0xJeremy/Icarus/README.md

# Icarus Power Distribution Board

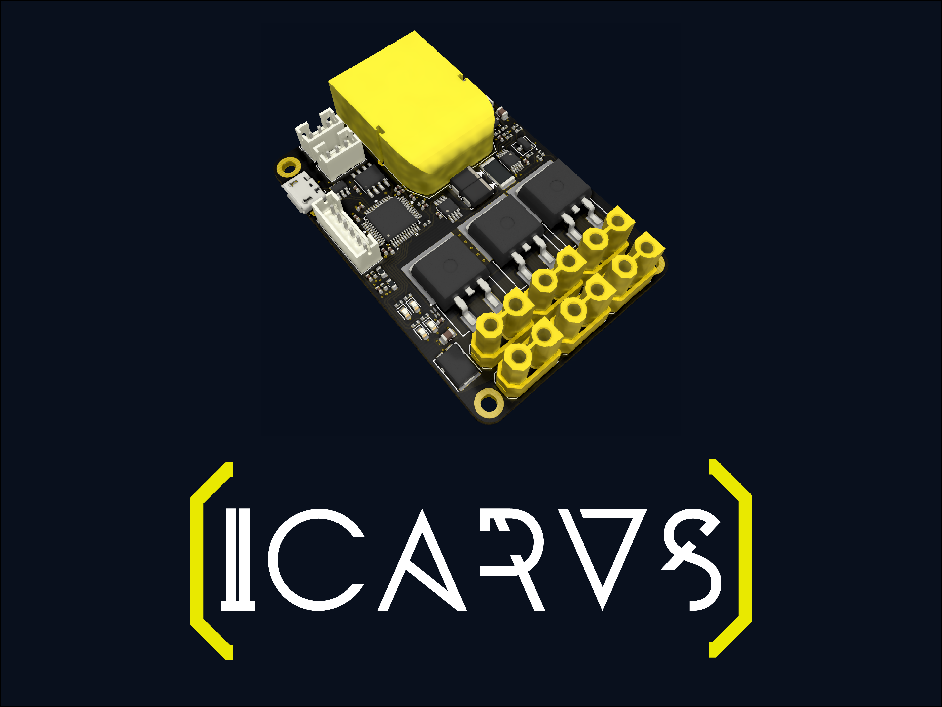
[picture p1: docs/logo/Icarus_Board.png]


### Board Layout
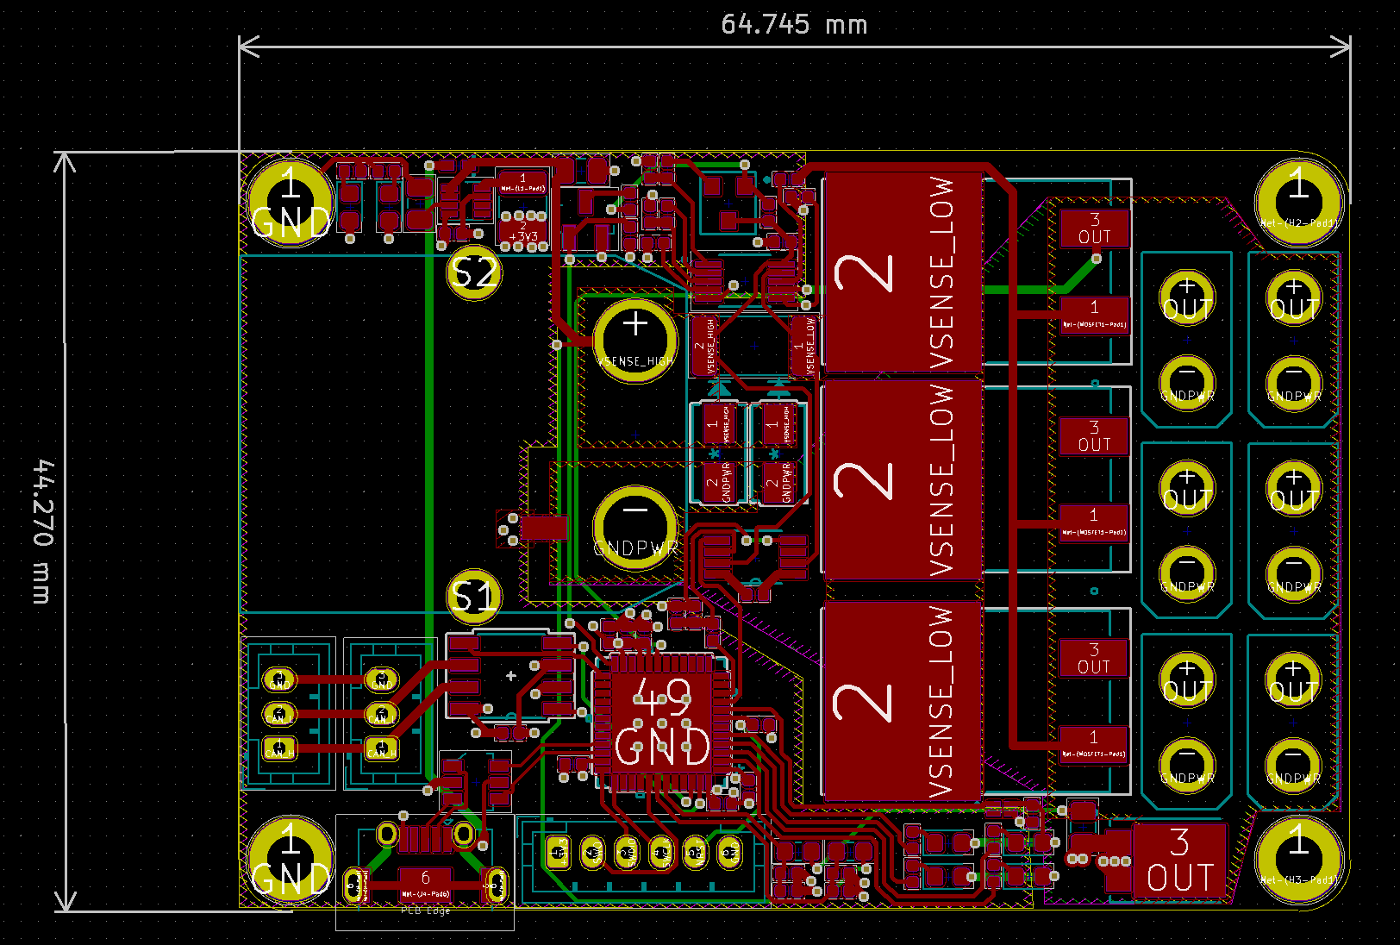
[picture p2: docs/Board_Layout.png]
Board Layout
