0xJeremy/Icarus/docs/Back.jpg

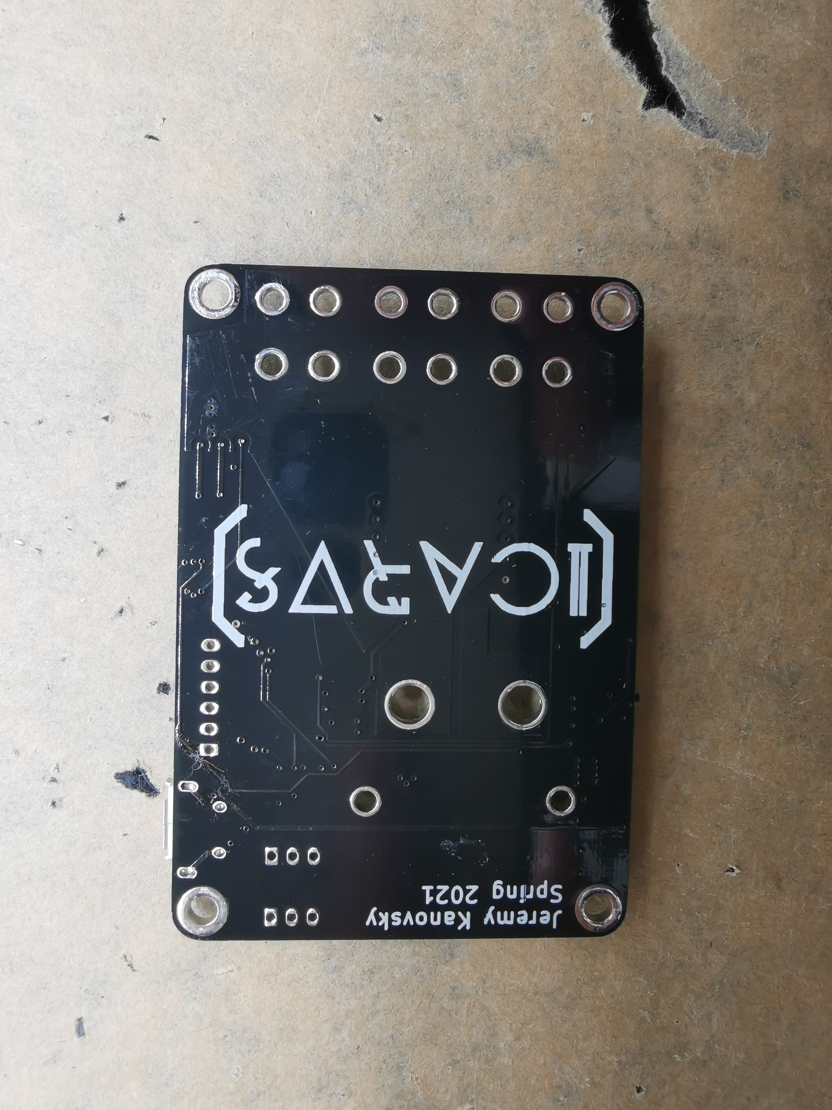
docs/Back.jpg
