0xJeremy/Icarus/docs/renders/Isometric.png

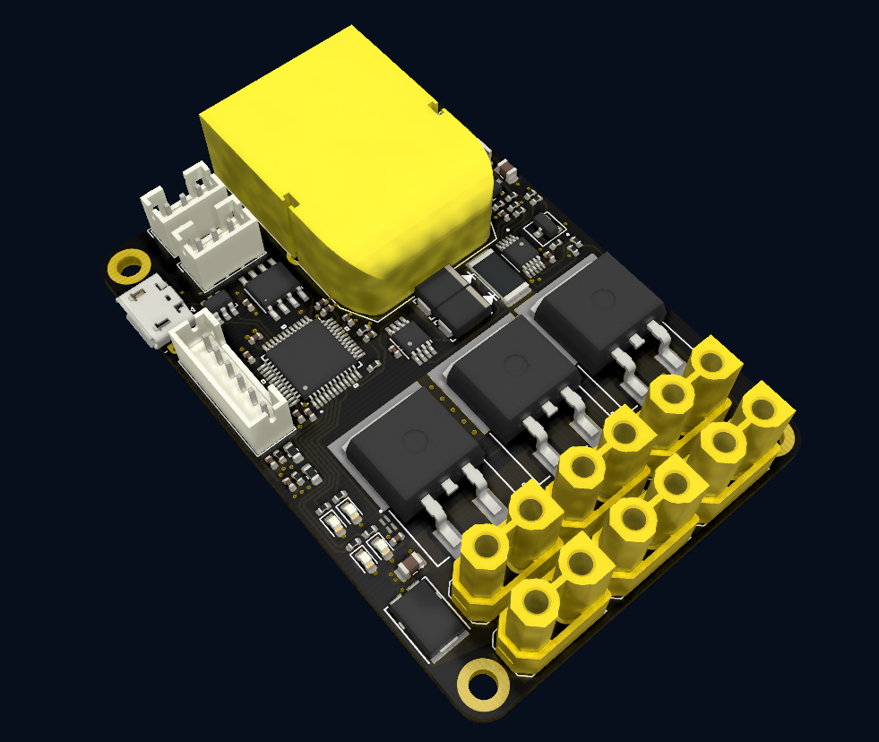
docs/renders/Isometric.png
