0xJeremy/Icarus/docs/renders/Side.png

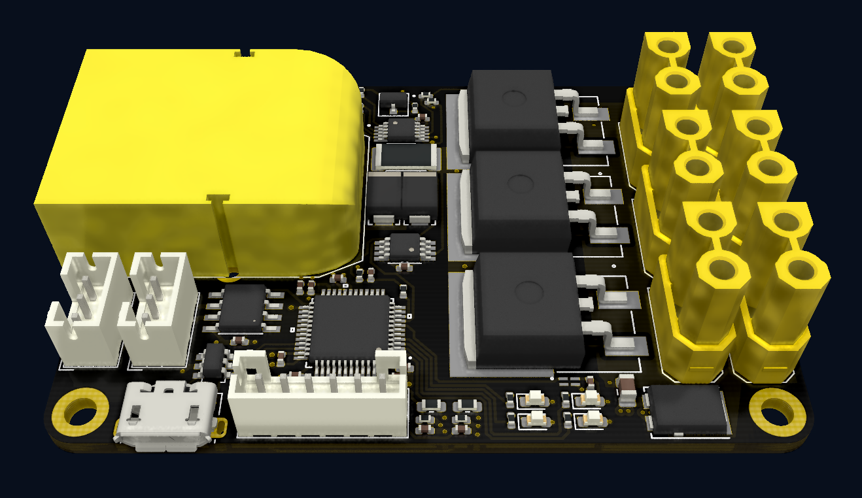
docs/renders/Side.png
