0xJeremy/Icarus/docs/renders/Top (Render).png

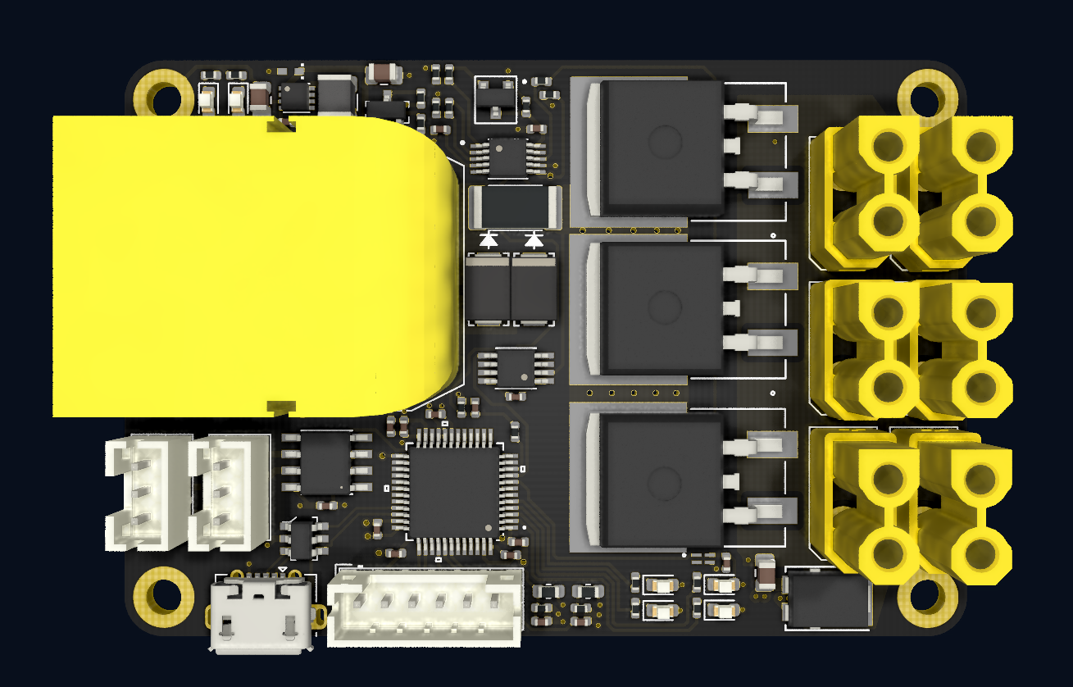
docs/renders/Top (Render).png
