0xJeremy/Icarus/docs/renders/Top.png

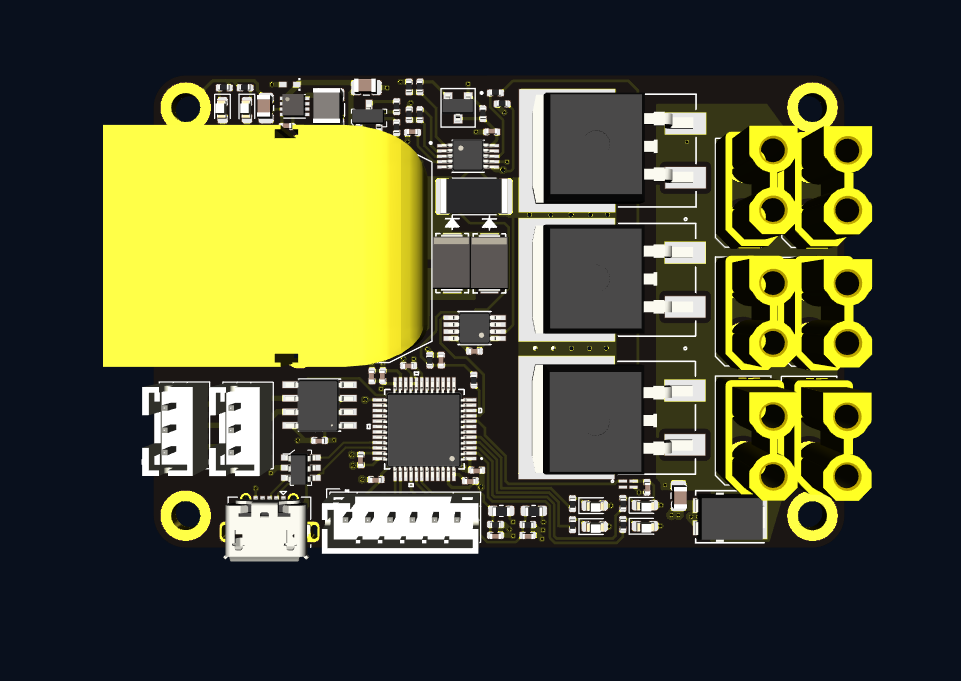
docs/renders/Top.png
