0xJeremy/Icarus/icarus_bom.xlsx

Item # | Designator | Qty | Manufacturer | Mfg Part # | Description/Value | Package/Footprint | Type | Your Instructions/Notes | Digi-Key/Mouser Link
1 | C14 | 1 | KEMET | C0402C103K5RECAUTO | CAP CER 10NF 50V 0402 | 0402 | SMD | NOTE: For all items I have included a link to Digi-Key or Mouser. It does not matter if the items are purchased from these sites or not, I included them as reference in case any of the manufacturer, manufacturer part numbers, or footprints are unclear. | https://www.digikey.com/en/products/detail/kemet/C0402C103K5RECAUTO/8646477
2 | C19 C18 | 2 | CAL-CHIP ELECTRONICS, INC. | GMC04X7R103K6R3NT | CAP CER 0.01UF 6.3V 0402 | 0402 | SMD |  | https://www.digikey.com/en/products/detail/cal-chip-electronics-inc/GMC04X7R103K6R3NT/13908424
3 | C3 C13 | 2 | Murata Electronics | GRJ155R60J106ME11D | CAP CER 10UF 6.3V 0402 | 0402 | SMD |  | https://www.digikey.com/en/products/detail/murata-electronics/GRJ155R60J106ME11D/5877374
4 | C4 C2 C7 | 3 | TDK Corporation | C2012X7S2A105K125AB | CAP CER 1UF 100V 0805 | 0805 | SMD |  | https://www.digikey.com/en/products/detail/tdk-corporation/C2012X7S2A105K125AB/2116321
5 | C6 | 1 | Murata Electronics | GRM155R62A104KE14D | CAP CER 0.1UF 100V 0402 | 0402 | SMD |  | https://www.digikey.com/en/products/detail/murata-electronics/GRM155R62A104KE14D/5027543
6 | C8 | 1 | Yageo | CC0402KRX5R5BB105 | CAP CER 1UF 6.3V 0402 | 0402 | SMD |  | https://www.digikey.com/en/products/detail/yageo/CC0402KRX5R5BB105/2833603
7 | C9 C10 C11 C1 C5 C15 C16 C17 C12 | 9 | CAL-CHIP ELECTRONICS, INC. | GMC04X5R104K10NT | CAP CER 0.1UF 10V 0402 | 0402 | SMD |  | https://www.digikey.com/en/products/detail/cal-chip-electronics-inc/GMC04X5R104K10NT/13908671
8 | CR1 CR2 | 2 | Vishay General Semiconductor - Diodes Division | SMBJ51CA-E3/52 | DIODE 82.4V 600W DO-214AA | DO-214AA | SMD |  | https://www.digikey.com/en/products/detail/vishay-semiconductor-diodes-division/smbj51ca-e3-52/1119303
9 | D1 | 1 | ON Semiconductor | ON Semiconductor | DIODE 30V 200MA SOD-523F | SOD-523F | SMD |  | https://www.digikey.com/en/products/detail/on-semiconductor/rb520s30/1955134
10 | D3 D2 | 2 | Kingbright | APT1608CGCK | LED 0603 GREEN | 0603 | SMD |  | https://www.digikey.com/en/products/detail/kingbright/APT1608CGCK/1747514
11 | D4 D5 D6 D7 | 4 | Rohm Semiconductor | SMLE13BC8TT86 | LED 0603 BLUE | 0603 | SMD |  | https://www.digikey.com/en/products/detail/rohm-semiconductor/SMLE13BC8TT86/5053771
12 | J4 | 1 | Molex | 475890001 | CONN MICRO USB B |  | SMD/Thru-hole |  | https://www.digikey.com/en/products/detail/molex/0475890001/1832253
13 | L1 | 1 | Taiyo Yuden | CBC3225T330KR | INDUCTOR 33UH 533MOHM 1210 | 1210 | SMD |  | https://www.digikey.com/en/products/detail/taiyo-yuden/CBC3225T330KR/2763320
14 | MOSFET1 MOSFET3 MOSFET5 | 3 | Nexperia USA Inc. | PSMN4R8-100BSEJ | N-CHANNEL MOSFET 100V 120A D2PAK | D2PAK | SMD |  | https://www.digikey.com/en/products/detail/nexperia-usa-inc/PSMN4R8-100BSEJ/4020506
15 | MOSFET2 | 1 | Diodes Incorporated | ZXMP10A13FTA | P-CHANNEL MOSFET 100V 600MA SOT-23-3 | SOT-23-3 | SMD |  | https://www.digikey.com/en/products/detail/diodes-incorporated/zxmp10a13fta/560644
16 | MOSFET4 | 1 | ON Semiconductor | BSS123 | N-CHANNEL MOSFET 100V 170MA SOT-23-3 | SOT-23-3 | SMD |  | https://www.digikey.com/en/products/detail/on-semiconductor/BSS123/244348
17 | R1 | 1 | Stackpole Electronics Inc | CSNL2512FTL500 | RESISTOR 500UOHM 1% 2W 2512 | 2512 | SMD |  | https://www.digikey.com/en/products/detail/stackpole-electronics-inc/CSNL2512FTL500/1788105
18 | R14 R2 | 2 | Yageo | RC0402FR-0747KL | RESITOR 47K OHM 1% 0402 | 0402 | SMD |  | https://www.digikey.com/en/products/detail/yageo/RC0402FR-0747KL/726616
19 | R15 | 1 | Panasonic Electronic Components | ERJ-2GEJ474X | RESISTOR 470K OHM 0402 | 0402 | SMD |  | https://www.digikey.com/en/products/detail/panasonic-electronic-components/ERJ-2GEJ474X/147018
20 | R16 R17 R18 | 3 | Venkel | CR0402-16W-6801FT | RESISTOR 6.8 KOHM 1% 0402 | 0402 | SMD |  | https://www.digikey.com/en/products/detail/venkel/CR0402-16W-6801FT/12329730
21 | R20 R19 | 2 | Yageo | RC0603FR-073ML | RESISTOR 3M OHM 0603 | 0603 | SMD |  | https://www.digikey.com/en/products/detail/yageo/RC0603FR-073ML/5918344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
22 | R22 R21 | 2 | Yageo | RC0402FR-07200KL | RESISTOR 200K OHM 1% 0402 | 0402 | SMD |  | https://www.digikey.com/en/products/detail/yageo/RC0402FR-07200KL/726558
23 | R3 R8 | 2 | Yageo | RC0402FR-07100KL | RESISTOR 100K OHM 0402 | 0402 | SMD |  | https://www.digikey.com/en/products/detail/yageo/RC0402FR-07100KL/726526
24 | R5 R10 R4 R11 R12 R13 | 6 | Venkel | CR0402-16W-221JT | RESISTOR 220 OHM 0402 | 0402 | SMD |  | https://www.digikey.com/en/products/detail/venkel/CR0402-16W-221JT/12329552
25 | R6 | 1 | Yageo | RC0402JR-0710RL | RESISTOR 10 OHM 0402 | 0402 | SMD |  | https://www.digikey.com/en/products/detail/yageo/RC0402JR-0710RL/726417
26 | R7 | 1 | KOA Speer Electronics, Inc. | RK73H1ETTP4993F | RESISTOR 499K OHM 1% 0402 | 0402 | SMD |  | https://www.digikey.com/en/products/detail/koa-speer-electronics-inc/RK73H1ETTP4993F/9844110
27 | R9 | 1 | Yageo | RC0402FR-07140KL | RESISTOR 140K OHM 1% 0402 | 0402 | SMD |  | https://www.digikey.com/en/products/detail/yageo/RC0402FR-07140KL/5280838
28 | U1 | 1 | Maxim Integrated | MAX15062AATA+T | IC VOLTAGE REGULATOR 3.3V 300MA 8-WFDFN | 8-WFDFN | SMD |  | https://www.digikey.com/en/products/detail/maxim-integrated/MAX15062AATA-T/2591307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
29 | U13 | 1 | Analog Devices Inc. | LT1787HVIMS8#PBF | IC CURRENSE SENSE AMPLIFIER 8-MSOP | 8-MSOP | SMD |  | https://www.mouser.com/ProductDetail/Analog-Devices/LT1787HVIMS8PBF
30 | U14 | 1 | STMicroelectronics | USBLC6-2SC6 | DIODE 17V 5A SOT-23-6 | SOT-23-6 | SMD |  | https://www.digikey.com/en/products/detail/stmicroelectronics/USBLC6-2SC6/1040559
31 | U15 | 1 | STMicroelectronics | STLM20DD9F | IC TEMPERATURE SENSOR 4-UDFN | 4-UDFN | SMD |  | https://www.digikey.com/en/products/detail/stmicroelectronics/STLM20DD9F/1506426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
32 | U2 | 1 | STMicroelectronics | STM32G474CET6 | IC STM32G474CET6 48-UFQFPN | 48-UFQFPN | SMD |  | https://www.digikey.com/en/products/detail/stmicroelectronics/STM32G474CET6/10326773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
33 | U3 | 1 | Texas Instruments | TCAN334GDR | IC CAN BUS DRIVER 8-SOIC | 8-SOIC | SMD |  | https://www.digikey.com/en/products/detail/texas-instruments/TCAN334GDR/5957539
34 | U5 | 1 | ON Semiconductor | FSV10150V | DIODE 150V 10A TO-277-3 | TO-277-3 | SMD |  | https://www.digikey.com/en/products/detail/on-semiconductor/fsv10150v/5306658
35 | U8 | 1 | Texas Instruments | TPS2490DGSR | IC HOT SWAP CONTROLLER 10-VSSOP | 10-VSSOP | SMD |  | https://www.mouser.com/ProductDetail/Texas-Instruments/TPS2490DGSR?qs=zwk82MlA57aRYVQqxqtqHA%3D%3D
