0xJeremy/Icarus/kicad/icarus_kicad_lib/RB520S30.step

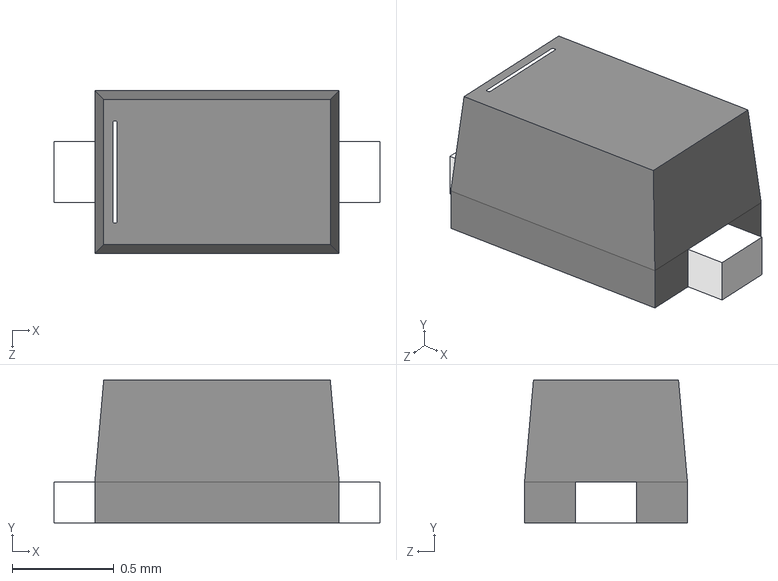
[picture p8: CAD file, 2021-03-07]
kicad/icarus_kicad_lib/RB520S30.step
1.60 x 0.7 x 0.8 mm
