0xJeremy/Icarus/kicad/icarus_kicad_lib/step/XT30_Male.step

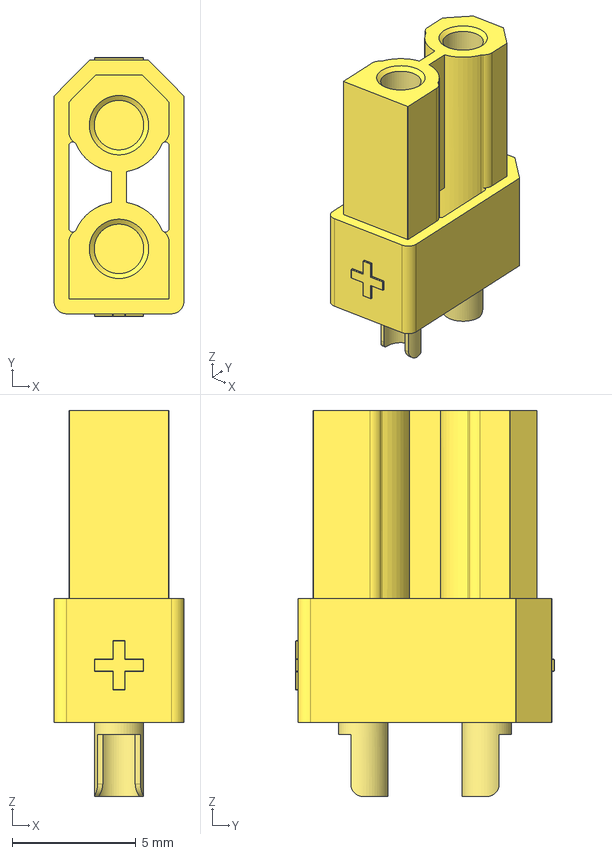
[picture p10: CAD file, 2021-03-31]
kicad/icarus_kicad_lib/step/XT30_Male.step
5.25 x 10.4 x 15.6 mm
