0xJeremy/Icarus/kicad/icarus_kicad_lib/step/XT90PW-F.STEP

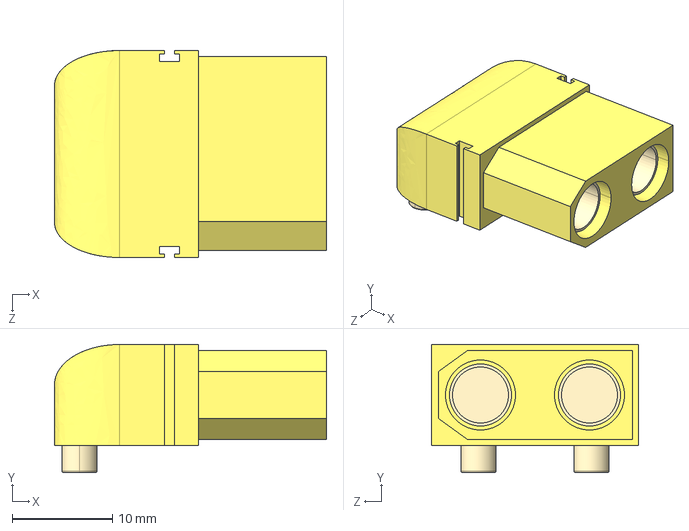
[picture p11: CAD file, 2021-03-31]
kicad/icarus_kicad_lib/step/XT90PW-F.STEP
27.2 x 12.8 x 20.7 mm
