0xJeremy/Icarus/kicad/icarus_kicad_lib/step/XT30.stp

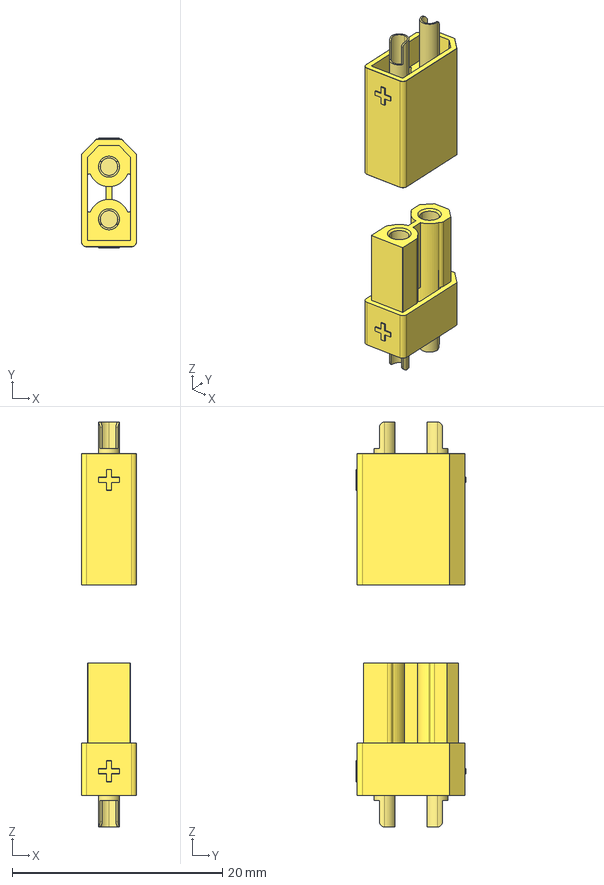
[picture p12: CAD file, 2021-03-31]
kicad/icarus_kicad_lib/step/XT30.stp
5.25 x 10.4 x 38.5 mm
