0xJeremy/Icarus/docs/icarus.pdf

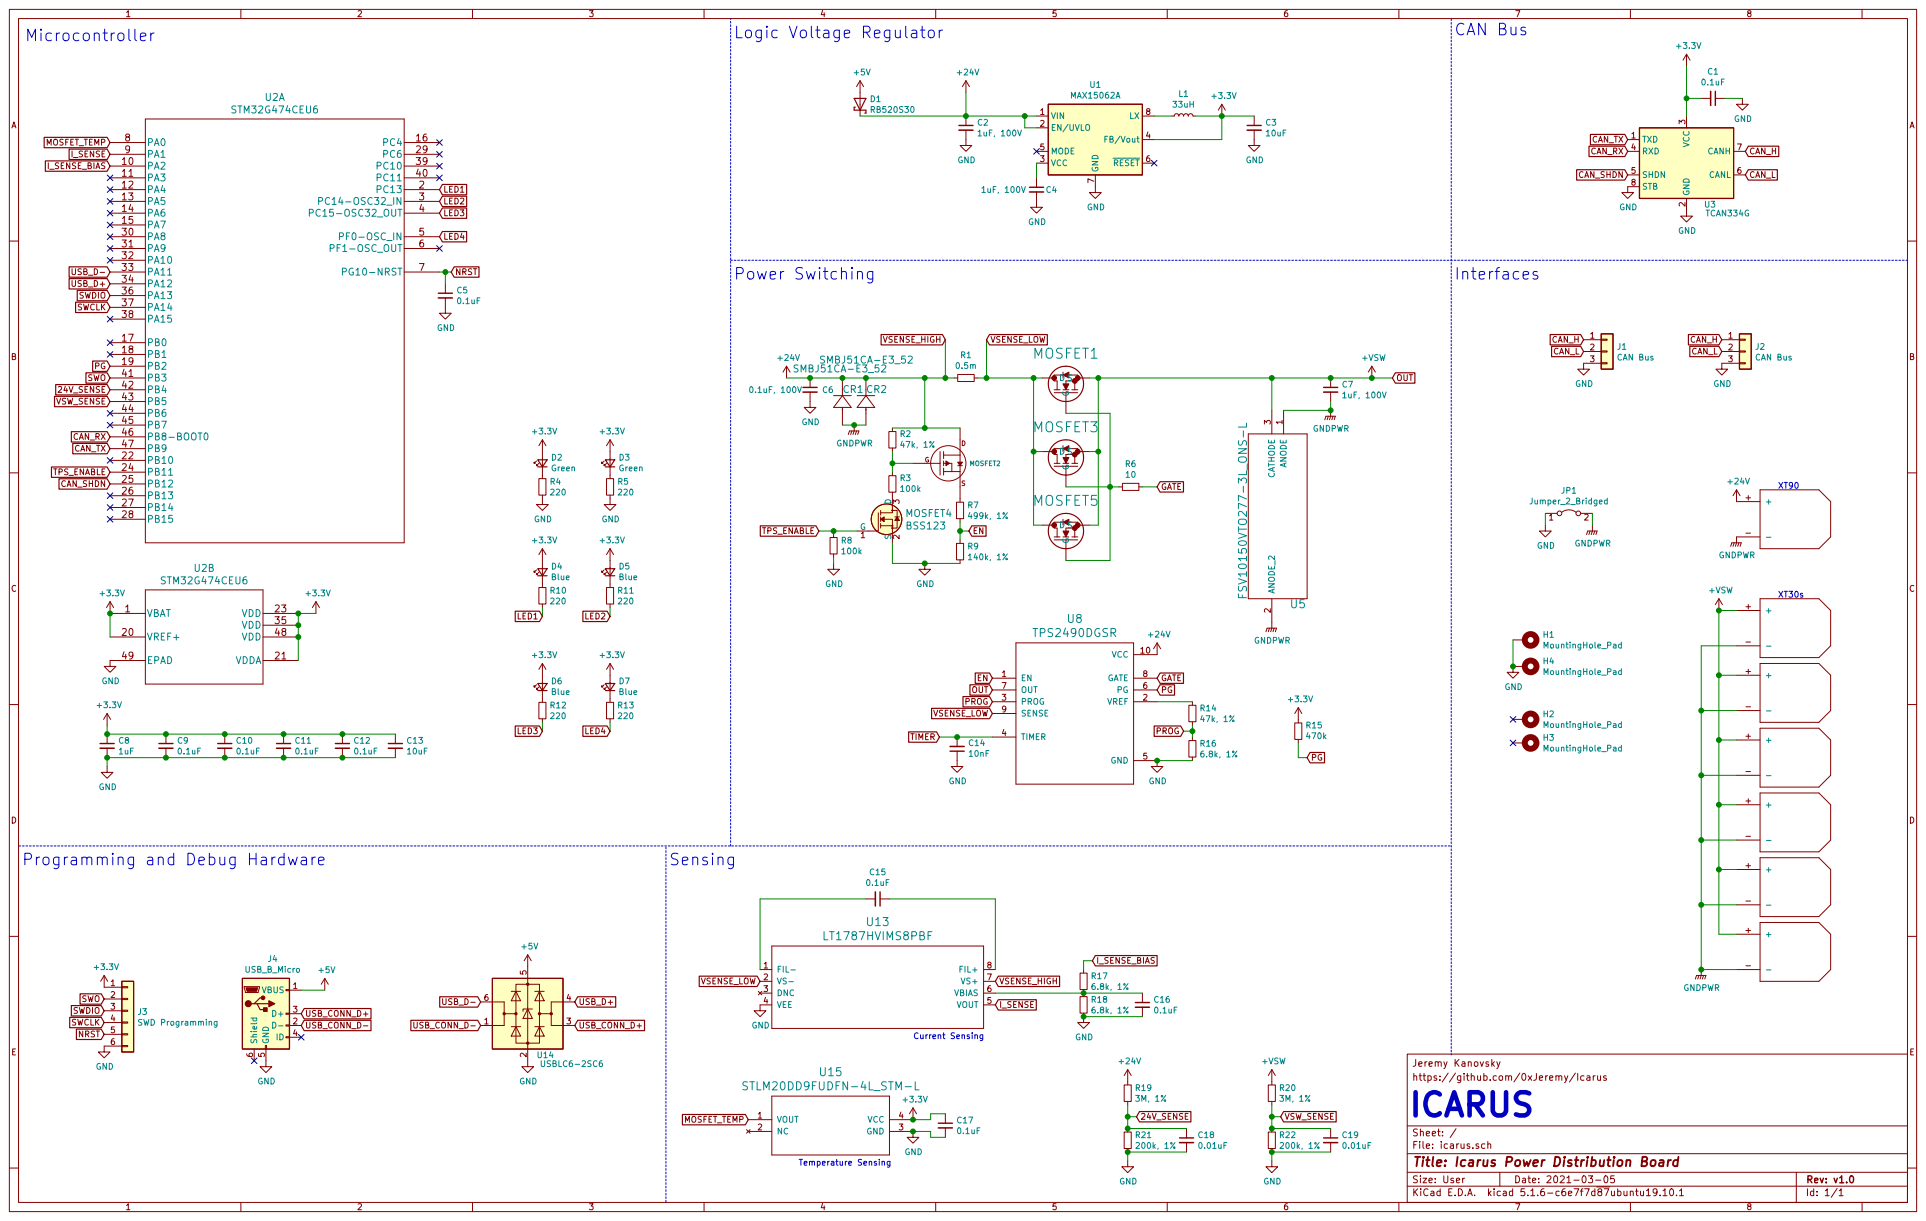
[picture p13: page 1]

Programming and Debug Hardware

Jeremy Kanovsky
File: icarus.sch Sheet: / https://github.com/0xJeremy/Icarus

Id: 1/1 Title: Icarus Power Distribution Board
