0xJeremy/Icarus/kicad/icarus.kicad_pcb

## KiCad design kicad/icarus.kicad_pcb (2021-05-07)

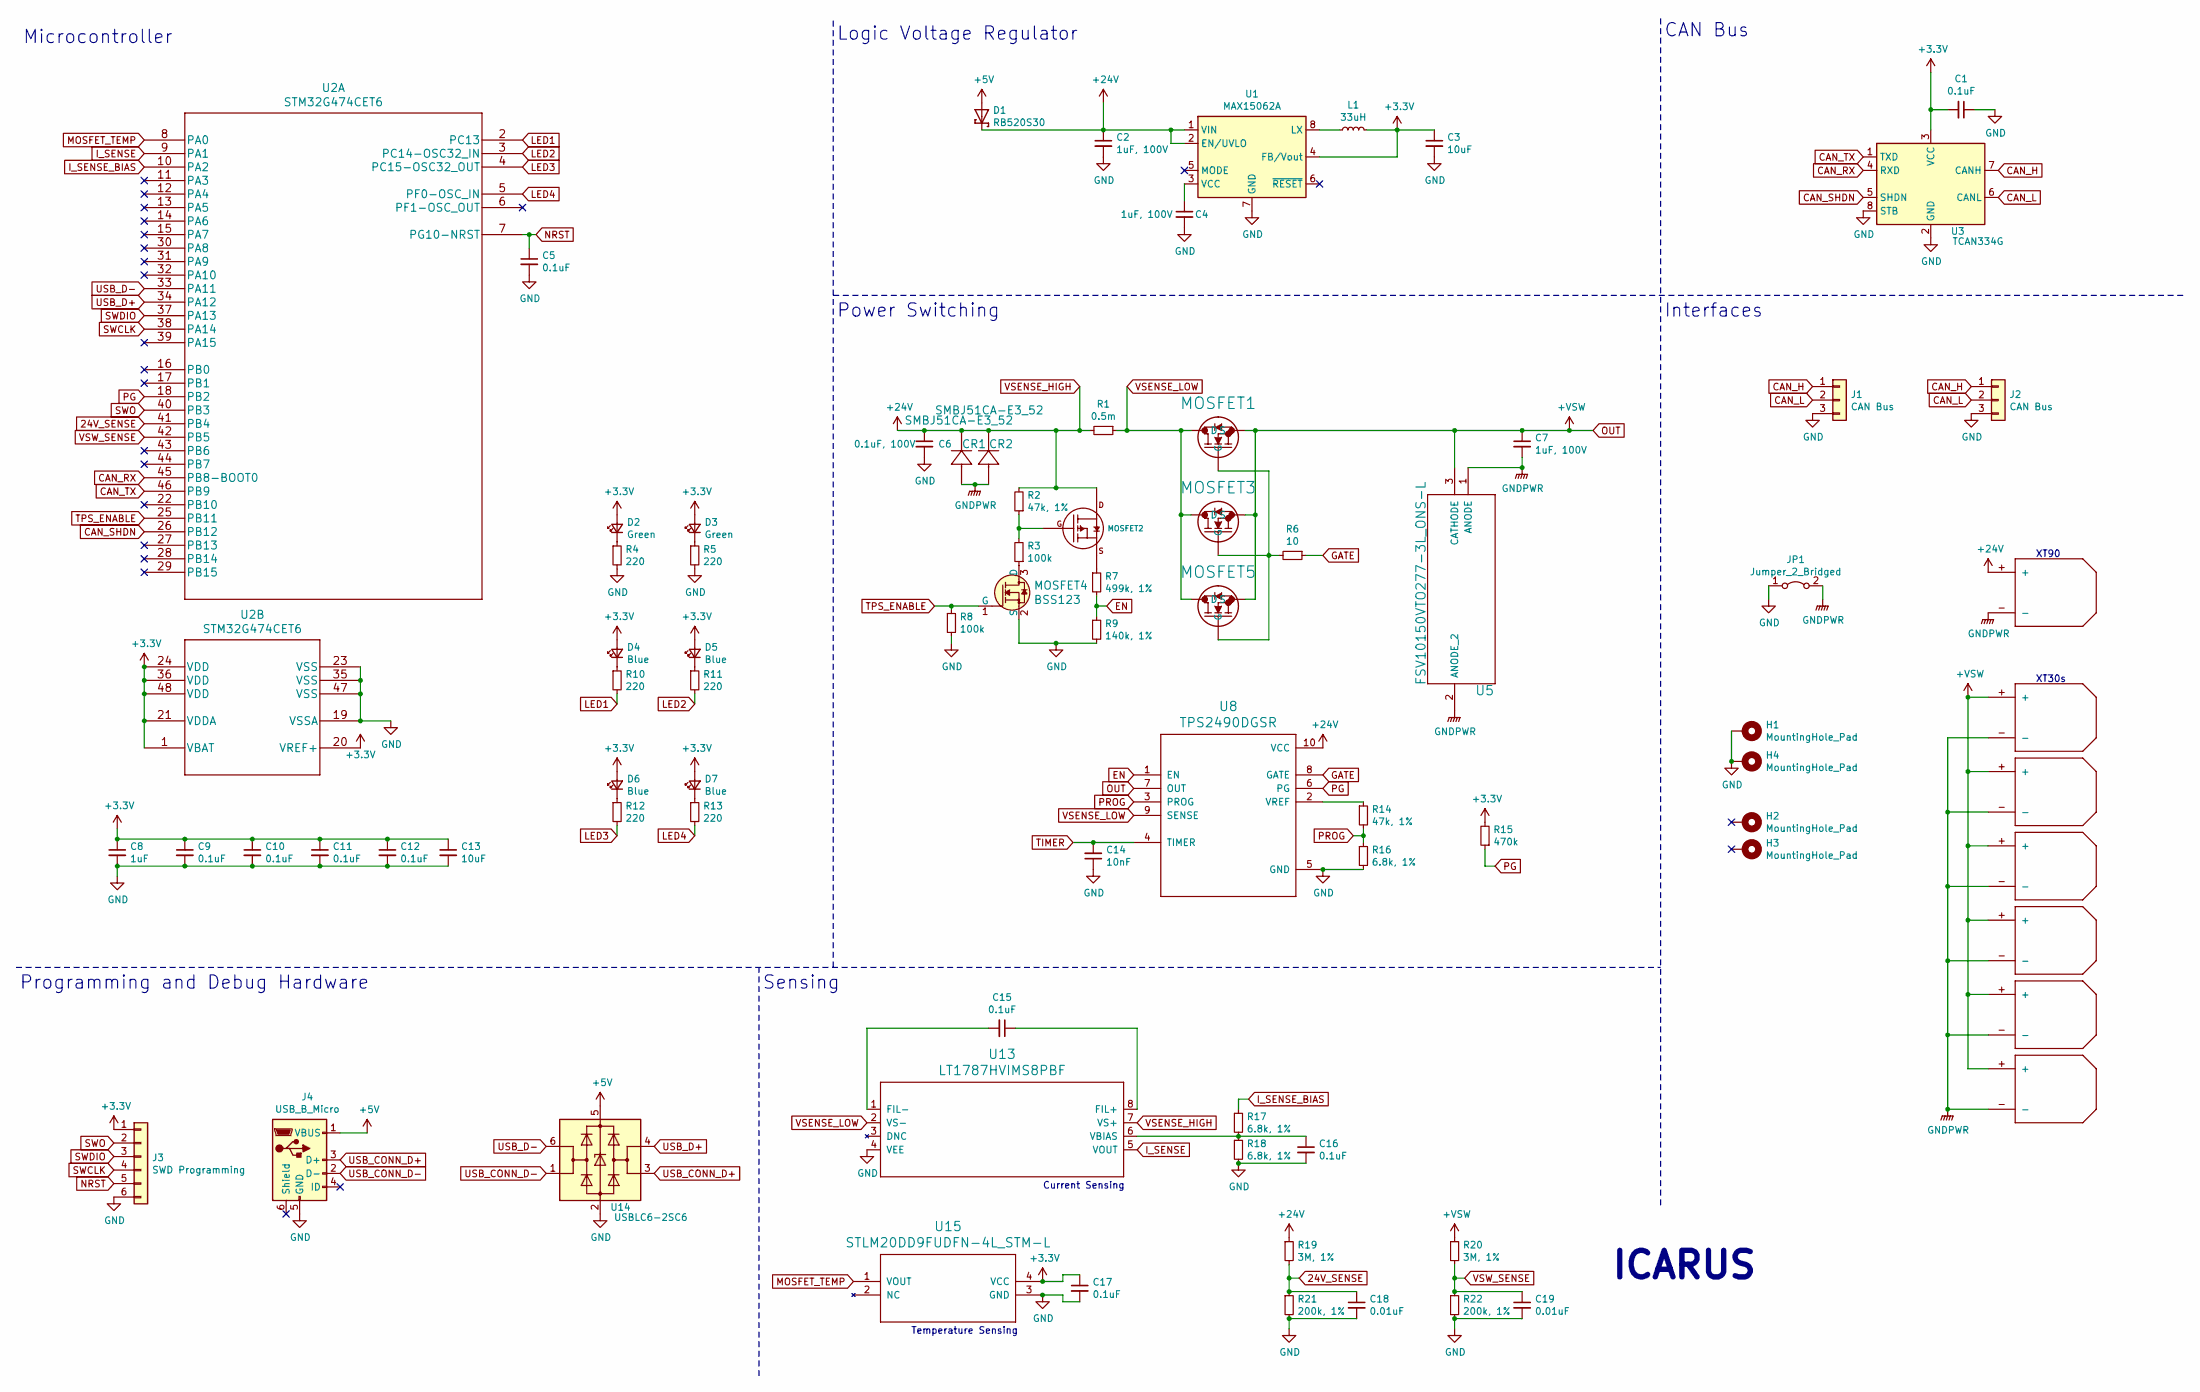
[picture p14: schematic icarus.sch, Icarus Power Distribution Board]

Parts:
C1, C5, C9, C10, C11, C12, C15, C16, C17: 0.1uF; C_0402_1005Metric
C2, C4, C7: 1uF, 100V; C_0805_2012Metric
C3, C13: 10uF; C_0402_1005Metric
C6: 0.1uF, 100V; C_0402_1005Metric
C8: 1uF; C_0402_1005Metric
C14: 10nF; C_0402_1005Metric
C18, C19: 0.01uF; C_0402_1005Metric
CR1, CR2: SMBJ51CA-E3_52; SMBJ51CA-E3-52
D1: RB520S30
D2, D3: Green; LED_0603_1608Metric
D4, D5, D6, D7: Blue; LED_0603_1608Metric
H1, H2, H3, H4: MountingHole_Pad; MountingHole_2.7mm_M2.5_DIN965_Pad
J1, J2: CAN Bus; JST_PH_B3B-PH-K_1x03_P2.00mm_Vertical
J3: SWD Programming; JST_PH_B6B-PH-K_1x06_P2.00mm_Vertical
J4: USB_B_Micro; USB_Micro-AB_Molex_47590-0001
JP1: Jumper_2_Bridged; SHORT_TOP-BIG
L1: 33uH; L_1210_3225Metric
MOSFET1, MOSFET3, MOSFET5: PSMN4R8-100BSEJ
MOSFET2: ZXMP10A13FTA
MOSFET4: BSS123; SOT-23-3; MPN BSS123; Digi-Key_PN BSS123NCT-ND
R1: 0.5m; R_2512_6332Metric
R2, R14: 47k, 1%; R_0402_1005Metric
R3, R8: 100k; R_0402_1005Metric
R4, R5, R10, R11, R12, R13: 220; R_0402_1005Metric
R6: 10; R_0402_1005Metric
R7: 499k, 1%; R_0402_1005Metric
R9: 140k, 1%; R_0402_1005Metric
R15: 470k; R_0402_1005Metric
R16, R17, R18: 6.8k, 1%; R_0402_1005Metric
R19, R20: 3M, 1%; R_0603_1608Metric
R21, R22: 200k, 1%; R_0402_1005Metric
U1: MAX15062A; DFN-8_2x2mm_P0.5mm
U2: STM32G474CET6
U3: TCAN334G
U4: XT90; XT90PW-M
U5: FSV10150VTO277-3L_ONS-L
U6, U7, U9, U10, U11, U12: XT30; XT30P
U8: TPS2490DGSR
U13: LT1787HVIMS8PBF
U14: USBLC6-2SC6; SOT-23-6
U15: STLM20DD9FUDFN-4L_STM-L

Connections:
24V_SENSE: C18.1, R19.2, R21.1, U2.41 (PB4)
+3V3: C1.2, C3.1, C8.1, C9.1, C10.1, C11.1, C12.1, C13.1, C17.1, D2.2 (A), D3.2 (A), D4.2 (A), D5.2 (A), D6.2 (A), D7.2 (A), J3.1, L1.2, R15.2, U1.4 (FB/Vout), U2.1 (VBAT), U2.20 (VREF+), U2.21 (VDDA), U2.24 (VDD), U2.36 (VDD), U2.48 (VDD), U3.3 (VCC), U15.4 (VCC)
+5V: D1.A, J4.1 (VBUS), U14.5 (VBUS)
CAN_H: J1.1, J2.1, U3.7 (CANH)
CAN_L: J1.2, J2.2, U3.6 (CANL)
CAN_RX: U2.45 (PB8-BOOT0), U3.4 (RXD)
CAN_SHDN: U2.26 (PB12), U3.5 (SHDN)
CAN_TX: U2.46 (PB9), U3.1 (TXD)
EN: R7.2, R9.1, U8.1 (EN)
GATE: R6.1, U8.8 (GATE)
GND: C1.1, C2.2, C3.2, C4.2, C5.2, C6.2, C8.2, C9.2, C10.2, C11.2, C12.2, C13.2, C14.1, C16.2, C17.2, C18.2, C19.2, H1.1, H4.1, J1.3, J2.3, J3.6, J4.5 (GND), JP1.1 (A), MOSFET4.2 (S), R4.2, R5.2, R8.2, R9.2, R16.2, R18.2, R21.2, R22.2, U1.7 (GND), U2.19 (VSSA), U2.23 (VSS), U2.35 (VSS), U2.47 (VSS), U3.2 (GND), U3.8 (STB), U8.5 (GND), U13.4 (VEE), U14.2 (GND), U15.3 (GND)
GNDPWR: C7.2, CR1.2, CR2.2, JP1.2 (B), U4.-, U5.1 (ANODE), U5.2 (ANODE_2), U6.-, U7.-, U9.-, U10.-, U11.-, U12.-
I_SENSE: U2.9 (PA1), U13.5 (VOUT)
I_SENSE_BIAS: R17.1, U2.10 (PA2)
LED1: R10.2, U2.2 (PC13)
LED2: R11.2, U2.3 (PC14-OSC32_IN)
LED3: R12.2, U2.4 (PC15-OSC32_OUT)
LED4: R13.2, U2.5 (PF0-OSC_IN)
MOSFET_TEMP: U2.8 (PA0), U15.1 (VOUT)
NRST: C5.1, J3.5, U2.7 (PG10-NRST)
unnamed: C4.1, U1.3 (VCC)
unnamed: C15.1, U13.8 (FIL+)
unnamed: C15.2, U13.1 (FIL-)
unnamed: C16.1, R17.2, R18.1, U13.6 (VBIAS)
unnamed: D2.1 (K), R4.1
unnamed: D3.1 (K), R5.1
unnamed: D4.1 (K), R10.1
unnamed: D5.1 (K), R11.1
unnamed: D6.1 (K), R12.1
unnamed: D7.1 (K), R13.1
unnamed: L1.1, U1.8 (LX)
unnamed: MOSFET1.1 (G), MOSFET3.1 (G), MOSFET5.1 (G), R6.2
unnamed: MOSFET2.P$1 (GATE), R2.1, R3.2
unnamed: MOSFET2.P$2 (SOURCE), R7.1
unnamed: MOSFET4.3 (D), R3.1
unnamed: R14.1, U8.2 (VREF)
OUT: C7.1, MOSFET1.3 (S), MOSFET3.3 (S), MOSFET5.3 (S), R20.1, U5.3 (CATHODE), U6.+, U7.+, U8.7 (OUT), U9.+, U10.+, U11.+, U12.+
PG: R15.1, U2.18 (PB2), U8.6 (PG)
PROG: R14.2, R16.1, U8.3 (PROG)
SWCLK: J3.4, U2.38 (PA14)
SWDIO: J3.3, U2.37 (PA13)
SWO: J3.2, U2.40 (PB3)
TIMER: C14.2, U8.4 (TIMER)
TPS_ENABLE: MOSFET4.1 (G), R8.1, U2.25 (PB11)
USB_CONN_D+: J4.3 (D+), U14.3 (I/O2)
USB_CONN_D-: J4.2 (D-), U14.1 (I/O1)
USB_D+: U2.34 (PA12), U14.4 (I/O2)
USB_D-: U2.33 (PA11), U14.6 (I/O1)
VSENSE_HIGH: C2.1, C6.1, CR1.1, CR2.1, D1.C, MOSFET2.P$3 (DRAIN), R1.2, R2.2, R19.1, U1.1 (VIN), U1.2 (EN/UVLO), U4.+, U8.10 (VCC), U13.7 (VS+)
VSENSE_LOW: MOSFET1.2 (D), MOSFET3.2 (D), MOSFET5.2 (D), R1.1, U8.9 (SENSE), U13.2 (VS-)
VSW_SENSE: C19.1, R20.2, R22.1, U2.42 (PB5)

Notes on the sheet:
ICARUS
Microcontroller
Programming and Debug Hardware
Logic Voltage Regulator
Power Switching
CAN Bus
Interfaces
Sensing
Current Sensing
Temperature Sensing
XT30s
XT90

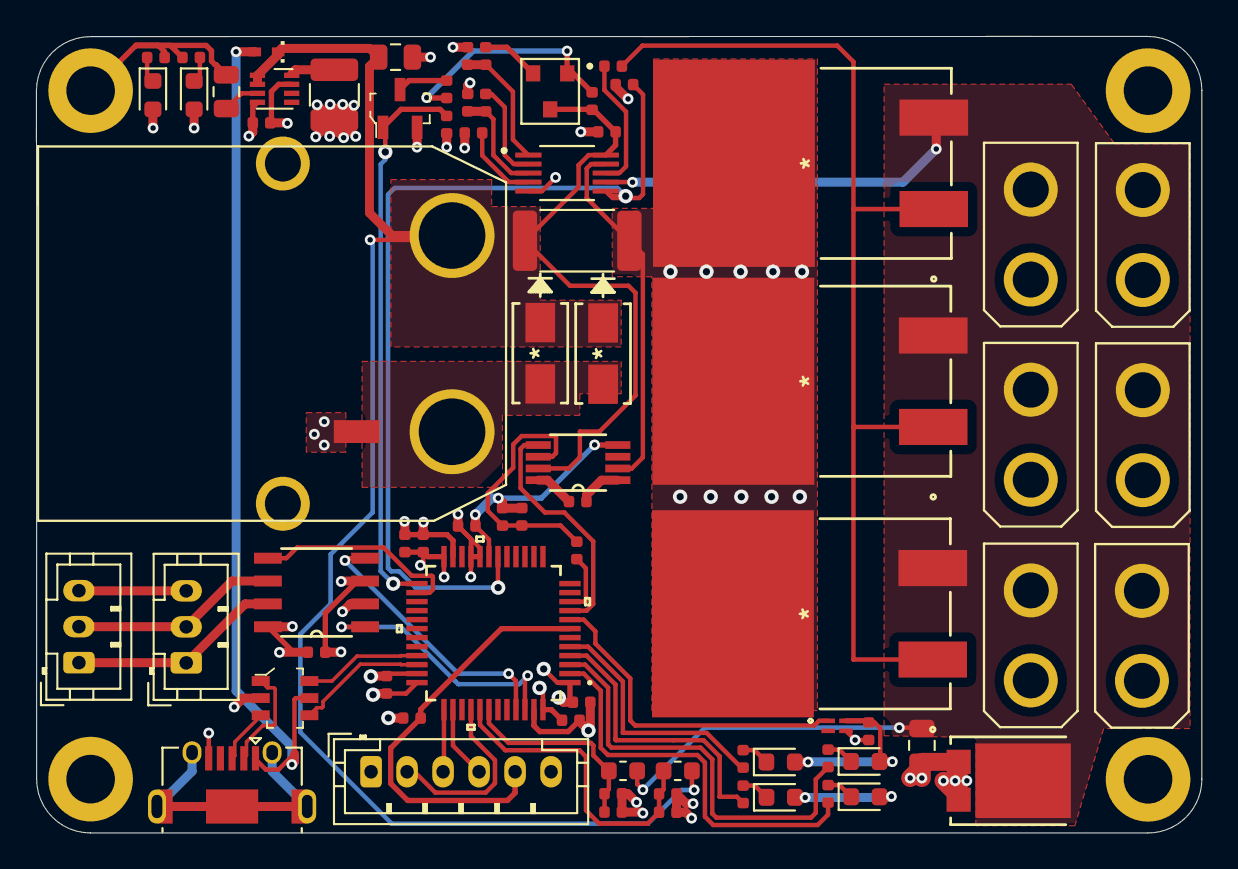
[picture p15: board icarus.kicad_pcb from above]

Board: 4 copper layers, 64.7 x 44.2 mm, 80 parts (0 on the bottom side), 51 nets.
