0xJeremy/Icarus/Icarus CubeMX Project Files/Icarus CubeMX Project Files.ioc

Mcu.UserName=STM32G474CEUx
PC13.Signal=GPIO_Output
PC14-OSC32_IN.Signal=GPIO_Output
PB11.Signal=GPIO_Output
PA13.Signal=SYS_JTMS-SWDIO
PA12.Signal=USB_DP
PC15-OSC32_OUT.Signal=GPIO_Output
PA1.Signal=ADC1_IN2
PB2.Signal=GPIO_Output
PB8-BOOT0.Signal=FDCAN1_RX
PA2.Signal=ADC1_IN3
PA0.Signal=ADC1_IN1
PB3.Signal=SYS_JTDO-SWO
PB5.Signal=GPIO_Input
PB9.Signal=FDCAN1_TX
PA11.Signal=USB_DM
PA14.Signal=SYS_JTCK-SWCLK
PF0-OSC_IN.Signal=GPIO_Output
PB12.Signal=GPIO_Output
PB4.Signal=GPIO_Input
PA3.Signal=ADC1_IN4
