0xJeremy/Icarus/(commit log)

2021-03-05 Began Icarus schematic, added CubeMX files
    [icarus.kicad_pcb, icarus.sch]
2021-03-05 Added schematic symbols, continued schematic layout
    [icarus.sch]
2021-03-06 Added voltage sensing
    [icarus.sch]
2021-03-06 Added mosfets to power driver enable, added parts values
    [icarus.sch]
2021-03-07 Updated schematic and CubeMX pinouts
    [icarus.sch]
2021-03-07 Added initial BOM
    [icarus_bom.csv, icarus_bom.xlsx]
2021-03-07 Added and assigned footprints, generated netlist
    [icarus.sch, icarus_bom.xlsx]
2021-03-07 Began fixing footprint disasters:
    [RB520S30.step, icarus.sch]
2021-03-07 Finished importing and modifying footprints
    [icarus.kicad_pcb, icarus.sch]
2021-03-07 Initial rough layout done
    [icarus.kicad_pcb, icarus.sch]
2021-03-07 Compressed board layout, about to start traces
    [icarus.kicad_pcb, icarus.sch]
2021-03-08 Began initial routing
    [icarus.kicad_pcb, icarus.sch]
2021-03-09 Added ground plane, adjusted schematic
    [icarus.kicad_pcb, icarus.sch]
2021-03-09 Layout v1.0 done
    [icarus.kicad_pcb, icarus.sch]
2021-03-11 Updated BOM, updated layout to fix design rules
    [icarus.kicad_pcb, icarus.sch, icarus_bom.csv, icarus_bom.xlsx]
2021-03-11 Updated BOM
    [icarus_bom.xlsx]
2021-03-15 Updated PCB layout
    [icarus.kicad_pcb]
2021-03-15 Added gerber and assembly files
    [icarus-B_Cu.gbr, icarus-B_Mask.gbr, icarus-B_Paste.gbr, icarus-B_SilkS.gbr, icarus-Edge_Cuts.gbr, icarus-F_Cu.gbr, icarus-F_Mask.gbr, icarus-F_Paste.gbr]
2021-03-17 Changed MCU due to sourcing problems
    [icarus-B_Cu.gbr, icarus-B_Mask.gbr, icarus-B_Paste.gbr, icarus-B_SilkS.gbr, icarus-Edge_Cuts.gbr, icarus-F_Cu.gbr, icarus-F_Mask.gbr, icarus-F_Paste.gbr]
2021-03-31 Updated 3D model
    [XT30.stp, XT30_Male.step, XT90PW-F.STEP, XT90PW-M.STEP, icarus.kicad_pcb]
2021-05-07 Added full position file, added images
    [icarus.kicad_pcb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]
